f1ux-capacitor/seezero-ihd-tap/(commit log)

2026-11-09 SeeZero IHD tap: ESPHome component, protocol docs and tools
    Local smart meter data from a geo SeeZero in-home display: the Zigbee
    radio -> host UART on J7 (3.57 Mbaud, AA AA framing, CRC-16/ARC) decoded
    into Home Assistant sensors via an ESPHome external component.
    Claude-Session: https://claude.ai/code/session_01LhromgQ1MkifvoWLcBZdhR
2026-11-10 Note that the C3 fits inside the closed IHD case
    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
2026-11-10 Confirm live power goes negative while exporting solar
    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
